MrSwirlyEyes/hardware-pcb-breakout-stm32wb55vgy6/bin/stm32wb55vgy6-breakout.step

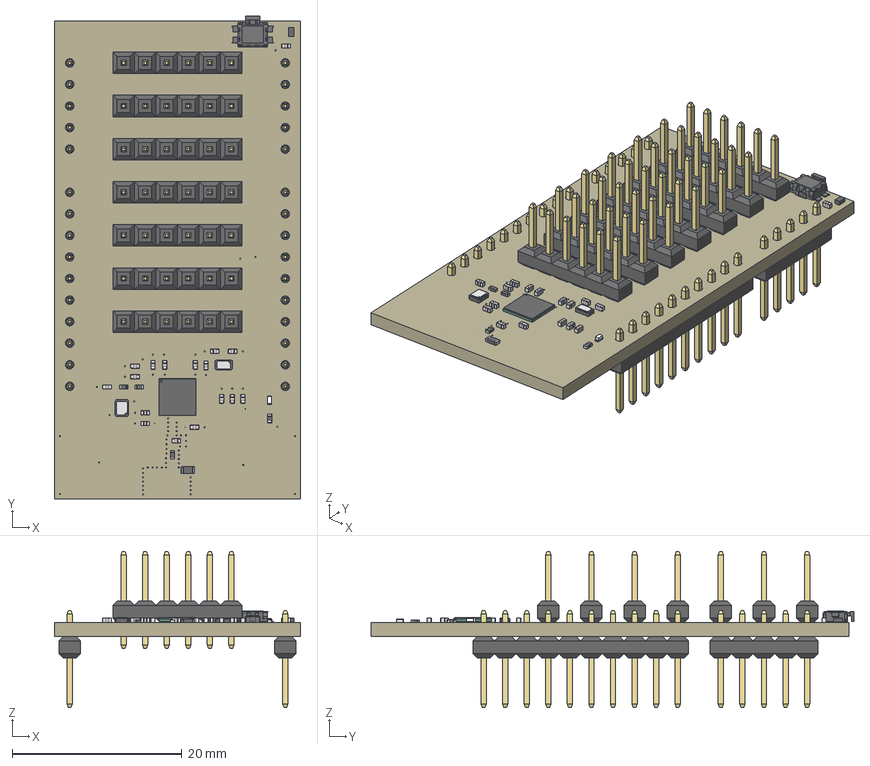
[picture p1: CAD file, 2021-01-17]
bin/stm32wb55vgy6-breakout.step
29.0 x 56.9 x 18.4 mm
Board
1x10 x 2
STM32WB55VGY6TR
1.5pF/50V/0402 x 17
32.768KHZ / 12.5PF
32MHZ / 10PF
1.8nH / 700mA x 3
2450AT14A0100T
PTS841 GM SMTR LFS
150mA/75V
PTH VERT MALE x 7
1x05 MALE VERT x 2
BLUE
10K
