MrSwirlyEyes/hardware-pcb-breakout-stm32wb55vgy6/src/stm32wb55vgy6-breakout.brd

## EAGLE design src/stm32wb55vgy6-breakout.brd (2021-01-17)

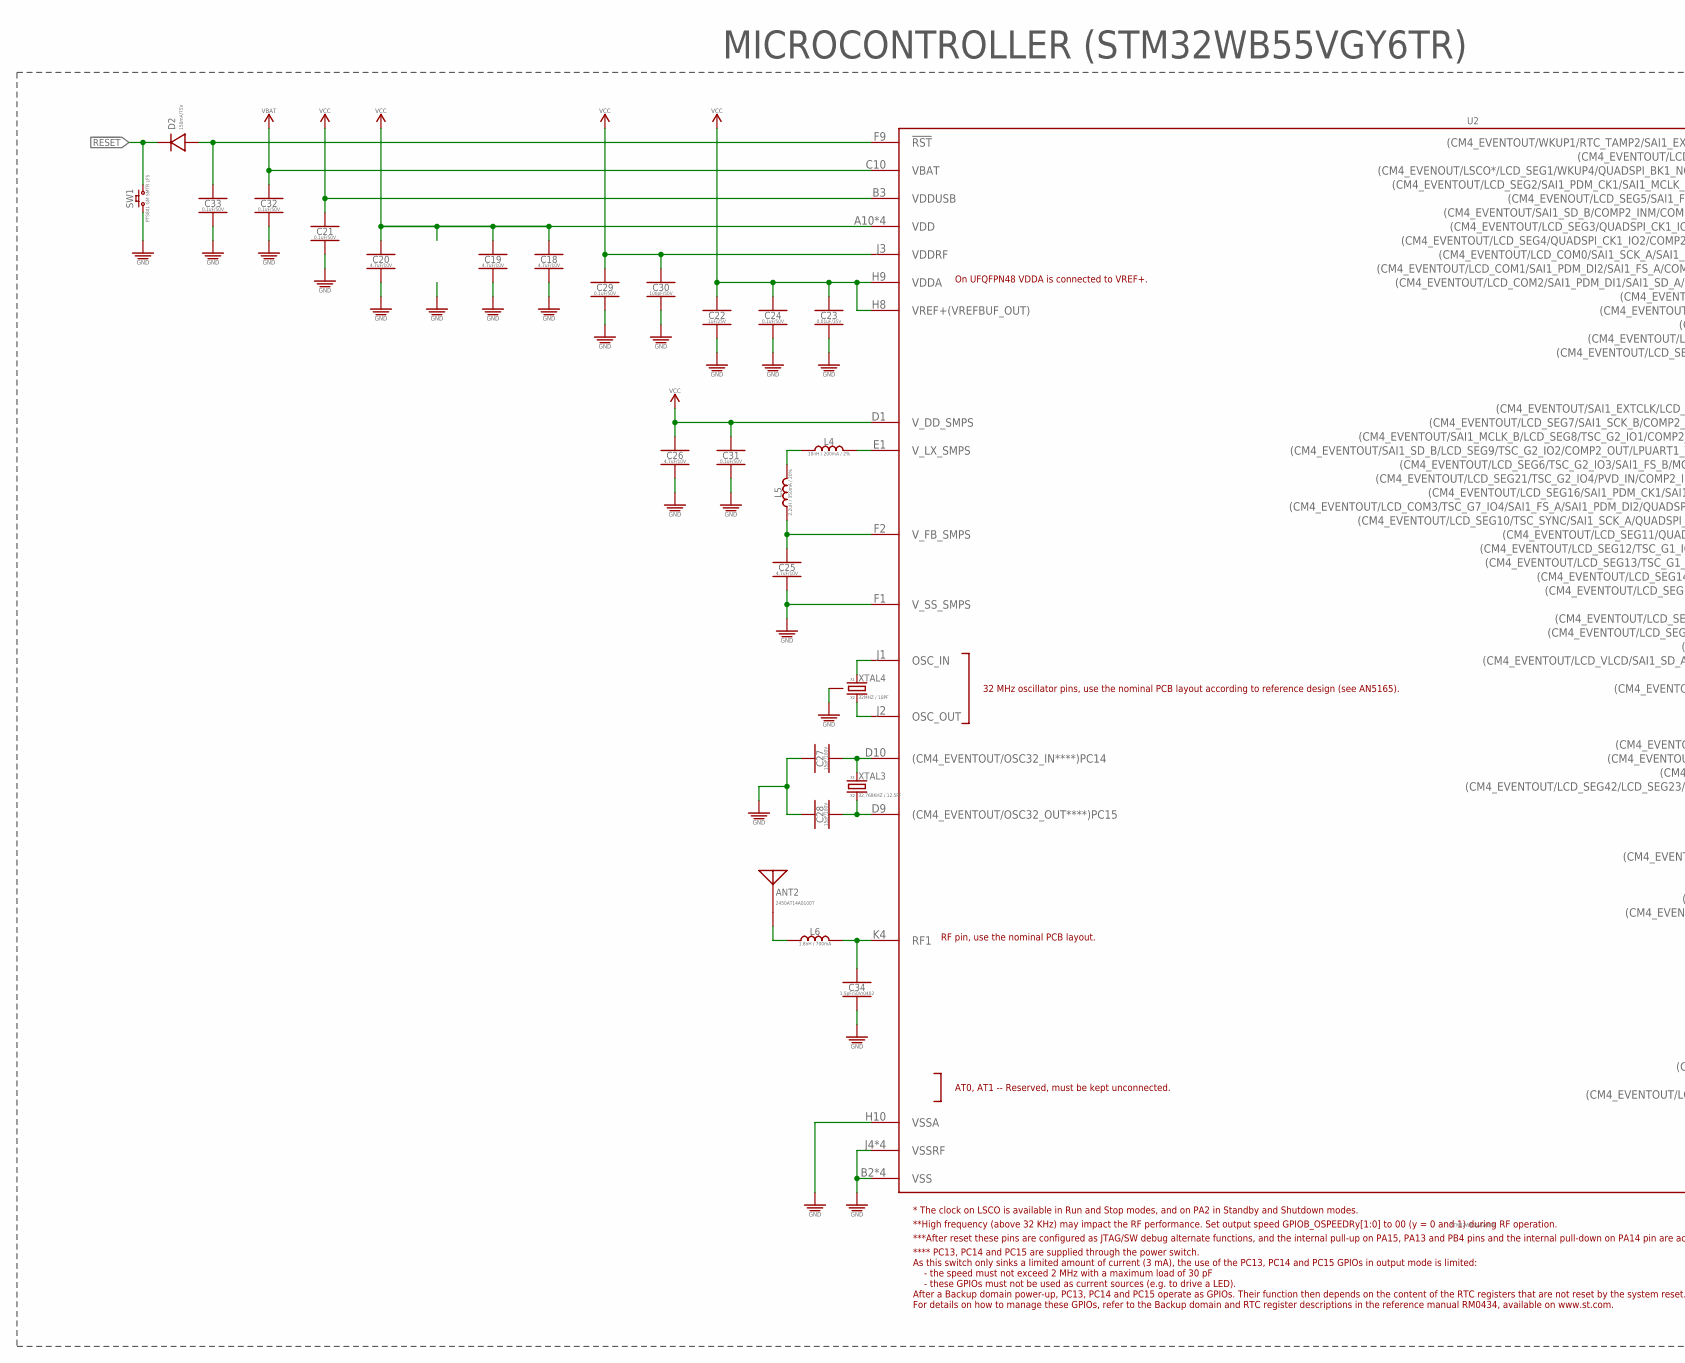
[picture p2: schematic stm32wb55vgy6-breakout.sch, part in row 1, column 1]

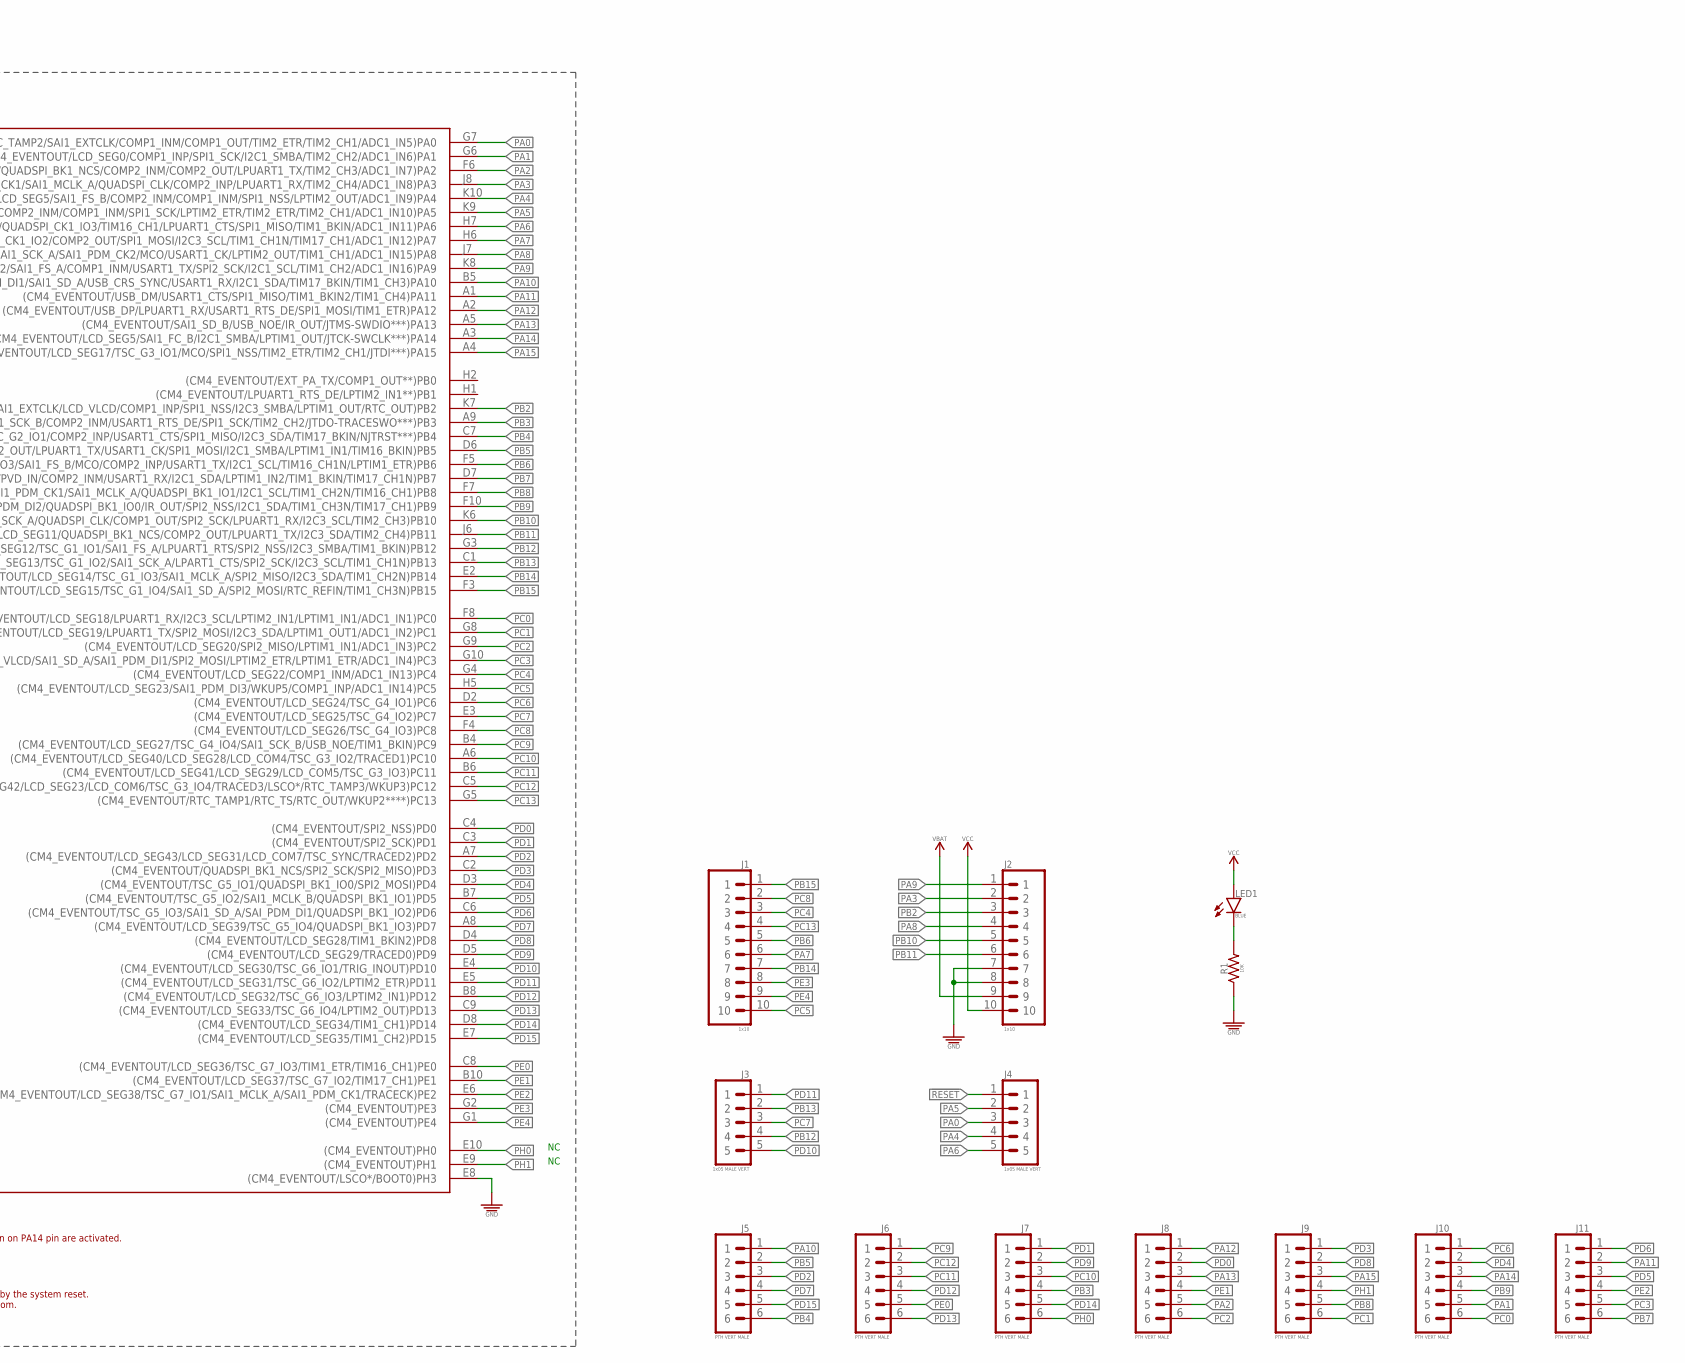
[picture p3: schematic stm32wb55vgy6-breakout.sch, part in row 1, column 2]

Parts:
ANT2: 2450AT14A0100T; RESC1608X40N
C18, C19, C20, C25, C26: 4.7uF/10V; CAPC1005X55_SMD-0402
C21, C24, C29, C31, C32, C33: 0.1uF/50V; CAPC1005X55_SMD-0402
C22: 1uF/25V; CAPC1005X55_SMD-0402
C23: 0.01uF/35V; CAPC1005X55_SMD-0402
C27, C28: 15pF/100V; CAPC1005X55_SMD-0402
C30: 100pF/50V; CAPC1005X55_SMD-0402
C34: 1.5pF/50V/0402; CAPC1005X55_SMD-0402
D2: 150mA/75V; DFN100X60X55-2
J1, J2: 1x10; HDRV10W64P254_1X10_2540X254X838B
J3, J4: 1x05 MALE VERT; HDRV5W64P254_1X5_1270X254X838B
J5, J6, J7, J8, J9, J10, J11: PTH VERT MALE; HDRV6W64P254_1X6_1524X254X838B
L4: 10nH / 200mA / 2%; INDC1005X32N
L5: 2.2uH / 350mA / 20%; INDC1005X32N
L6: 1.8nH / 700mA; INDC1005X32N
LED1: BLUE; LEDC1005X40_LED-0402
R1: 10K; RESC1005X35_SMD-0402
SW1: PTS841 GM SMTR LFS; SW_MOMENTARY_SPST-NO_PTS841-GM-SMTR-LFS
U2: STM32WB55VGY6TR; BGA100N40P10X10_438X440X59N
XTAL3: 32.768KHZ / 12.5PF; OSCCC205X120X55N
XTAL4: 32MHZ / 10PF; OSCCC200X160X59N

Connections:
!RESET!: D2.K, J4.1, SW1.3 (2), SW1.4 (2)
FEED: ANT2.FEED, L6.1
GND: C18.2, C19.2, C20.2, C21.2, C22.2, C23.2, C24.2, C25.2, C26.2, C27.1, C28.1, C29.2, C30.2, C31.2, C32.2, C33.2, C34.2, J2.7, J2.8, R1.1, SW1.1, SW1.2 (1), U2.B2 (VSS), U2.B9 (VSS), U2.E8 ((CM4_EVENTOUT/LSCO*/BOOT0)PH3), U2.F1 (V_SS_SMPS), U2.H10 (VSSA), U2.J4 (VSSRF), U2.J5 (VSS), U2.J9 (VSS), U2.K1 (VSSRF), U2.K2 (VSSRF), U2.K3 (VSSRF), XTAL4.2 (GND), XTAL4.4 (GND)
unnamed: LED1.K, R1.2
unnamed: L4.1, L5.2
unnamed: C25.1, L5.1, U2.F2 (V_FB_SMPS)
unnamed: U2.J1 (OSC_IN), XTAL4.1 (XTAL1)
unnamed: U2.J2 (OSC_OUT), XTAL4.3 (XTAL2)
unnamed: C27.2, U2.D10 ((CM4_EVENTOUT/OSC32_IN****)PC14), XTAL3.X1
unnamed: C28.2, U2.D9 ((CM4_EVENTOUT/OSC32_OUT****)PC15), XTAL3.X2
unnamed: L4.2, U2.E1 (V_LX_SMPS)
unnamed: C33.1, D2.A, U2.F9 (!RST!)
PA0: J4.3, U2.G7 ((CM4_EVENTOUT/WKUP1/RTC_TAMP2/SAI1_EXTC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)
PA1: J10.5, U2.G6 ((CM4_EVENTOUT/LCD_SEG0/COMP1_INP/SPI1_S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)
PA2: J8.5, U2.F6 ((CM4_EVENOUT/LSCO*/LCD_SEG1/WKUP4/QUADS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)
PA3: J2.2, U2.J8 ((CM4_EVENTOUT/LCD_SEG2/SAI1_PDM_CK1/SAI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)
PA4: J4.4, U2.K10 ((CM4_EVENOUT/LCD_SEG5/SAI1_FS_B/COMP2_I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)
PA5: J4.2, U2.K9 ((CM4_EVENTOUT/SAI1_SD_B/COMP2_INM/COMP1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)
PA6: J4.5, U2.H7 ((CM4_EVENTOUT/LCD_SEG3/QUADSPI_CK1_IO3/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)
PA7: J1.6, U2.H6 ((CM4_EVENTOUT/LCD_SEG4/QUADSPI_CK1_IO2/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)
PA8: J2.4, U2.J7 ((CM4_EVENTOUT/LCD_COM0/SAI1_SCK_A/SAI1_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)
PA9: J2.1, U2.K8 ((CM4_EVENTOUT/LCD_COM1/SAI1_PDM_DI2/SAI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)
PA10: J5.1, U2.B5 ((CM4_EVENTOUT/LCD_COM2/SAI1_PDM_DI1/SAI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)
PA11: J11.2, U2.A1 ((CM4_EVENTOUT/USB_DM/USART1_CTS/SPI1_MI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)
PA12: J8.1, U2.A2 ((CM4_EVENTOUT/USB_DP/LPUART1_RX/USART1_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)
PA13: J8.3, U2.A5 ((CM4_EVENTOUT/SAI1_SD_B/USB_NOE/IR_OUT/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)
PA14: J10.3, U2.A3 ((CM4_EVENTOUT/LCD_SEG5/SAI1_FC_B/I2C1_S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)
PA15: J9.3, U2.A4 ((CM4_EVENTOUT/LCD_SEG17/TSC_G3_IO1/MCO/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)
PB2: J2.3, U2.K7 ((CM4_EVENTOUT/SAI1_EXTCLK/LCD_VLCD/COMP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)
PB3: J7.4, U2.A9 ((CM4_EVENTOUT/LCD_SEG7/SAI1_SCK_B/COMP2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)
PB4: J5.6, U2.C7 ((CM4_EVENTOUT/SAI1_MCLK_B/LCD_SEG8/TSC_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)
PB5: J5.2, U2.D6 ((CM4_EVENTOUT/SAI1_SD_B/LCD_SEG9/TSC_G2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)
PB6: J1.5, U2.F5 ((CM4_EVENTOUT/LCD_SEG6/TSC_G2_IO3/SAI1_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)
PB7: J11.6, U2.D7 ((CM4_EVENTOUT/LCD_SEG21/TSC_G2_IO4/PVD_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)
PB8: J9.5, U2.F7 ((CM4_EVENTOUT/LCD_SEG16/SAI1_PDM_CK1/SA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)
PB9: J10.4, U2.F10 ((CM4_EVENTOUT/LCD_COM3/TSC_G7_IO4/SAI1_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)
PB10: J2.5, U2.K6 ((CM4_EVENTOUT/LCD_SEG10/TSC_SYNC/SAI1_S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)
PB11: J2.6, U2.J6 ((CM4_EVENTOUT/LCD_SEG11/QUADSPI_BK1_NCS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)
PB12: J3.4, U2.G3 ((CM4_EVENTOUT/LCD_SEG12/TSC_G1_IO1/SAI1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)
PB13: J3.2, U2.C1 ((CM4_EVENTOUT/LCD_SEG13/TSC_G1_IO2/SAI1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)
PB14: J1.7, U2.E2 ((CM4_EVENTOUT/LCD_SEG14/TSC_G1_IO3/SAI1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)
PB15: J1.1, U2.F3 ((CM4_EVENTOUT/LCD_SEG15/TSC_G1_IO4/SAI1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)
PC0: J10.6, U2.F8 ((CM4_EVENTOUT/LCD_SEG18/LPUART1_RX/I2C3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)
PC1: J9.6, U2.G8 ((CM4_EVENTOUT/LCD_SEG19/LPUART1_TX/SPI2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)
PC2: J8.6, U2.G9 ((CM4_EVENTOUT/LCD_SEG20/SPI2_MISO/LPTIM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)
PC3: J11.5, U2.G10 ((CM4_EVENTOUT/LCD_VLCD/SAI1_SD_A/SAI1_P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)
PC4: J1.3, U2.G4 ((CM4_EVENTOUT/LCD_SEG22/COMP1_INM/ADC1_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)
PC5: J1.10, U2.H5 ((CM4_EVENTOUT/LCD_SEG23/SAI1_PDM_DI3/WK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)
PC6: J10.1, U2.D2 ((CM4_EVENTOUT/LCD_SEG24/TSC_G4_IO1)PC6)
PC7: J3.3, U2.E3 ((CM4_EVENTOUT/LCD_SEG25/TSC_G4_IO2)PC7)
PC8: J1.2, U2.F4 ((CM4_EVENTOUT/LCD_SEG26/TSC_G4_IO3)PC8)
PC9: J6.1, U2.B4 ((CM4_EVENTOUT/LCD_SEG27/TSC_G4_IO4/SAI1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)
PC10: J7.3, U2.A6 ((CM4_EVENTOUT/LCD_SEG40/LCD_SEG28/LCD_C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)
PC11: J6.3, U2.B6 ((CM4_EVENTOUT/LCD_SEG41/LCD_SEG29/LCD_C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)
PC12: J6.2, U2.C5 ((CM4_EVENTOUT/LCD_SEG42/LCD_SEG23/LCD_C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)
PC13: J1.4, U2.G5 ((CM4_EVENTOUT/RTC_TAMP1/RTC_TS/RTC_OUT/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)
PD0: J8.2, U2.C4 ((CM4_EVENTOUT/SPI2_NSS)PD0)
PD1: J7.1, U2.C3 ((CM4_EVENTOUT/SPI2_SCK)PD1)
PD2: J5.3, U2.A7 ((CM4_EVENTOUT/LCD_SEG43/LCD_SEG31/LCD_C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)
PD3: J9.1, U2.C2 ((CM4_EVENTOUT/QUADSPI_BK1_NCS/SPI2_SCK/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)
PD4: J10.2, U2.D3 ((CM4_EVENTOUT/TSC_G5_IO1/QUADSPI_BK1_IO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)
PD5: J11.3, U2.B7 ((CM4_EVENTOUT/TSC_G5_IO2/SAI1_MCLK_B/QU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)
PD6: J11.1, U2.C6 ((CM4_EVENTOUT/TSC_G5_IO3/SAI1_SD_A/SAI_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)
PD7: J5.4, U2.A8 ((CM4_EVENTOUT/LCD_SEG39/TSC_G5_IO4/QUAD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)
PD8: J9.2, U2.D4 ((CM4_EVENTOUT/LCD_SEG28/TIM1_BKIN2)PD8)
PD9: J7.2, U2.D5 ((CM4_EVENTOUT/LCD_SEG29/TRACED0)PD9)
PD10: J3.5, U2.E4 ((CM4_EVENTOUT/LCD_SEG30/TSC_G6_IO1/TRIG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)
PD11: J3.1, U2.E5 ((CM4_EVENTOUT/LCD_SEG31/TSC_G6_IO2/LPTI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)
PD12: J6.4, U2.B8 ((CM4_EVENTOUT/LCD_SEG32/TSC_G6_IO3/LPTI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)
PD13: J6.6, U2.C9 ((CM4_EVENTOUT/LCD_SEG33/TSC_G6_IO4/LPTI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)
PD14: J7.5, U2.D8 ((CM4_EVENTOUT/LCD_SEG34/TIM1_CH1)PD14)
PD15: J5.5, U2.E7 ((CM4_EVENTOUT/LCD_SEG35/TIM1_CH2)PD15)
PE0: J6.5, U2.C8 ((CM4_EVENTOUT/LCD_SEG36/TSC_G7_IO3/TIM1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)
PE1: J8.4, U2.B10 ((CM4_EVENTOUT/LCD_SEG37/TSC_G7_IO2/TIM1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)
PE2: J11.4, U2.E6 ((CM4_EVENTOUT/LCD_SEG38/TSC_G7_IO1/SAI1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)
PE3: J1.8, U2.G2 ((CM4_EVENTOUT)PE3)
PE4: J1.9, U2.G1 ((CM4_EVENTOUT)PE4)
PH0: J7.6, U2.E10 ((CM4_EVENTOUT)PH0)
PH1: J9.4, U2.E9 ((CM4_EVENTOUT)PH1)
RF: C34.1, L6.2, U2.K4 (RF1)
VBAT: C32.1, J2.9, U2.C10 (VBAT)
VCC: C18.1, C19.1, C20.1, C21.1, C22.1, C23.1, C24.1, C26.1, C29.1, C30.1, C31.1, J2.10, LED1.A, U2.A10 (VDD), U2.B1 (VDD), U2.B3 (VDDUSB), U2.D1 (V_DD_SMPS), U2.H8 (VREF+(VREFBUF_OUT)), U2.H9 (VDDA), U2.J3 (VDDRF), U2.J10 (VDD), U2.K5 (VDD)

Notes on the sheet:
MICROCONTROLLER (STM32WB55VGY6TR)

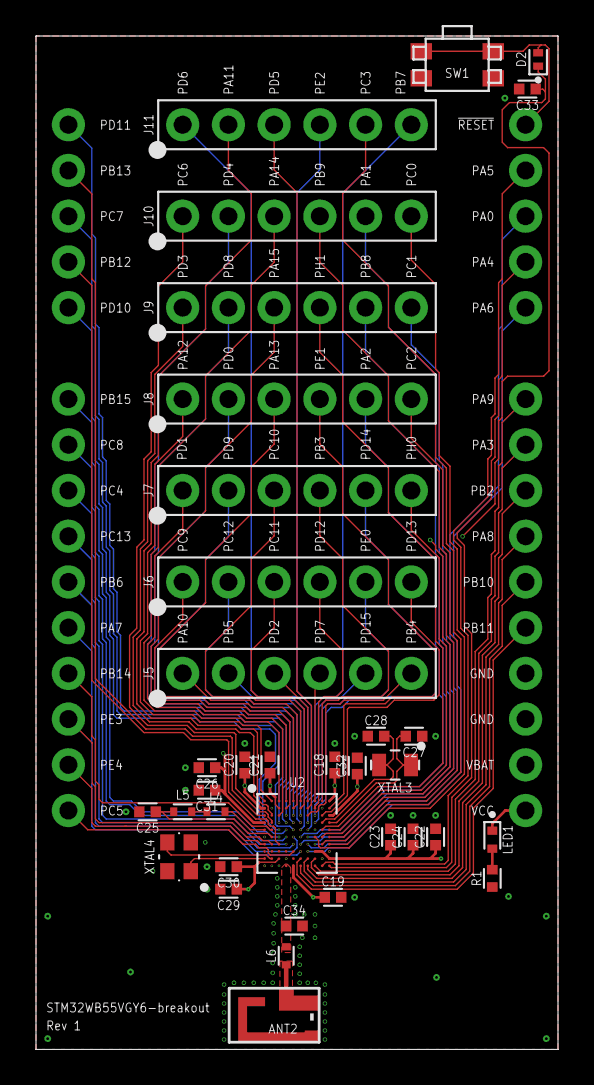
[picture p4: board stm32wb55vgy6-breakout.brd from above]

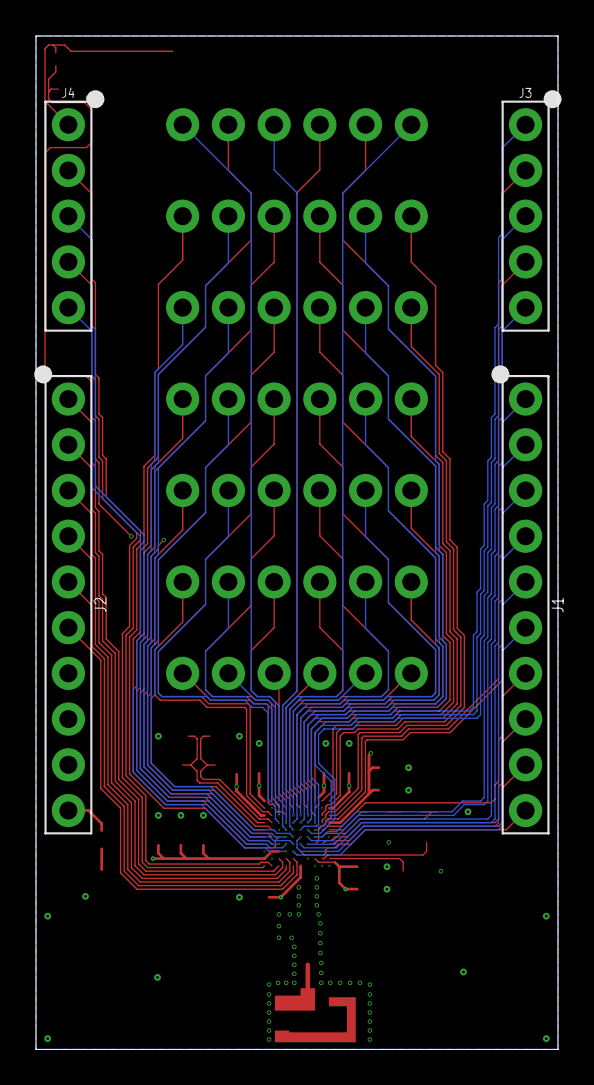
[picture p5: board stm32wb55vgy6-breakout.brd from below]

Board: 4 copper layers, 29.0 x 56.3 mm, 39 parts (4 on the bottom side), 82 nets.
