MrSwirlyEyes/hardware-pcb-breakout-stm32wb55vgy6/(commit log)

2021-01-12 [Rev 1] - Initialize repo.
    [stm32wb55vgy6-breakout.brd, stm32wb55vgy6-breakout.csv, stm32wb55vgy6-breakout.sch, stm32wb55vgy6-breakout.step]
2021-01-17 [Rev 1] - Adjusted antenna microstrip width to more closely approximate a 50 ohm impedence. Added LED power indicator to VCC. Moved antenna circuitry to center of the board instead of the corner.
    [stm32wb55vgy6-breakout.brd, stm32wb55vgy6-breakout.csv, stm32wb55vgy6-breakout.sch, stm32wb55vgy6-breakout.step]
2021-08-11 Update CAM files.
    [stm32wb55vgy6-breakout.csv, stm32wb55vgy6-breakout.step]
